EWU-IEEE-Spokane/squid-game-system/Control PCB/control/control.kicad_pcb

## KiCad design Control PCB/control/control.kicad_pcb (2022-09-03)

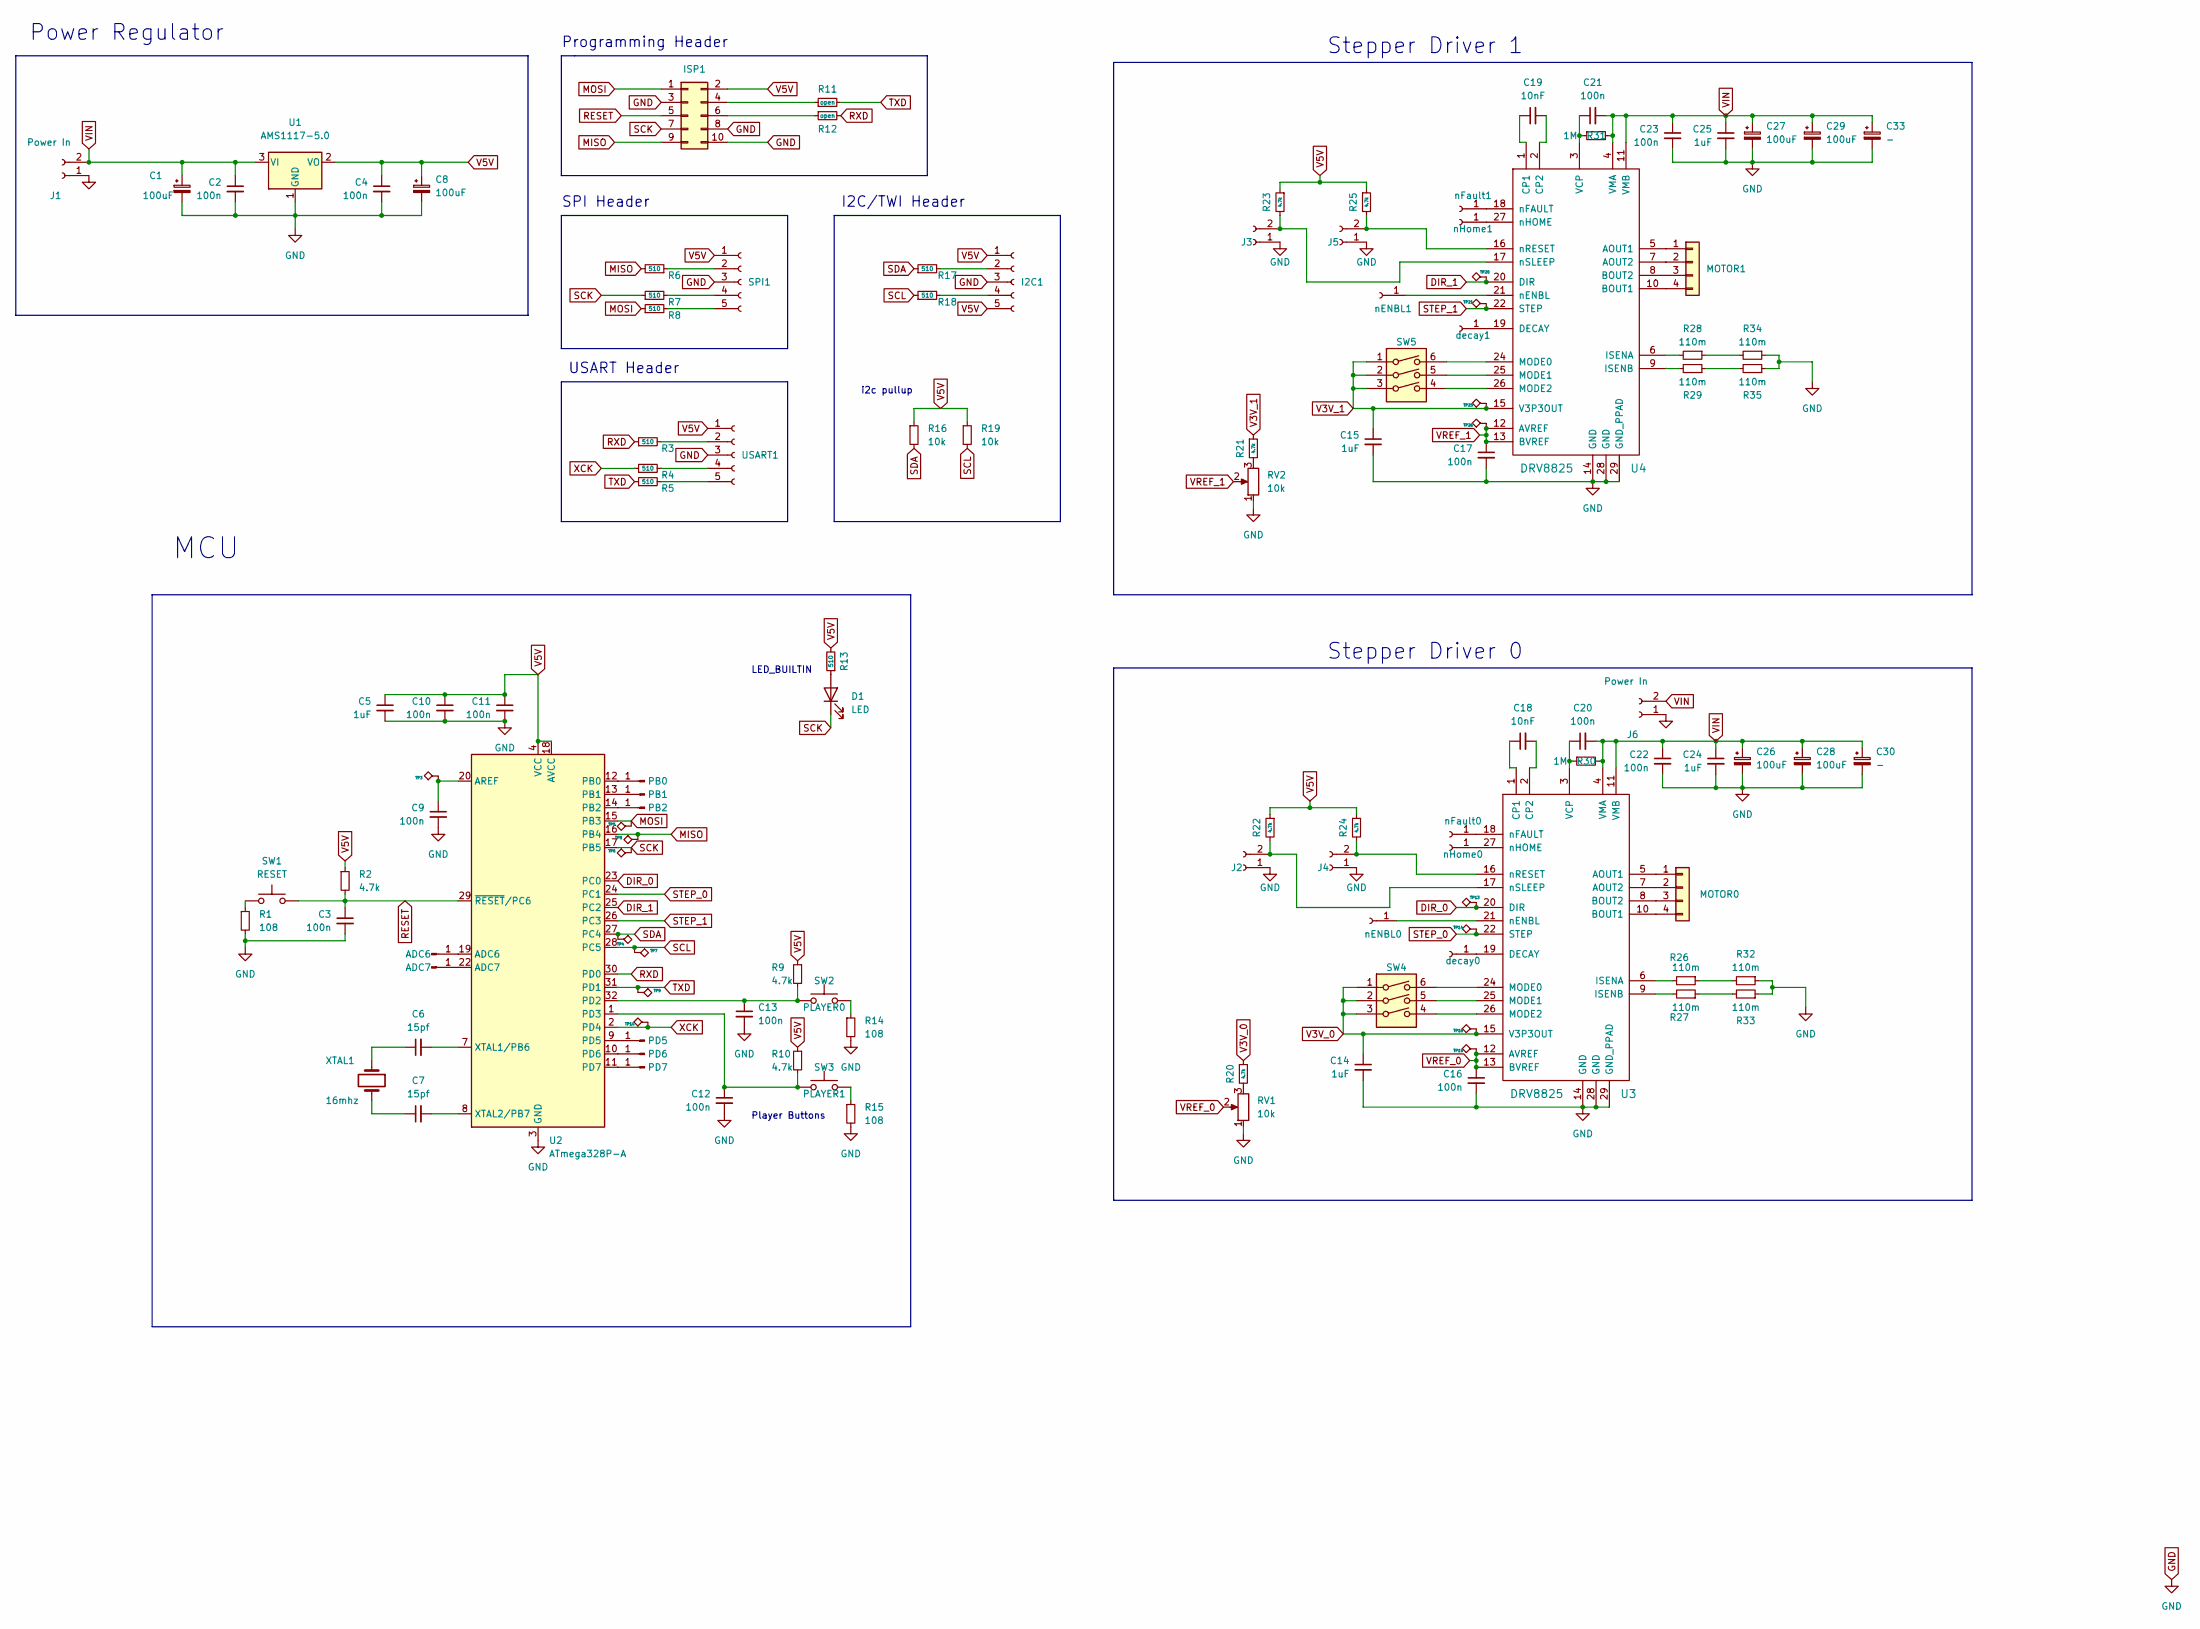
[picture p1: schematic control.kicad_sch]

Parts:
ADC6, ADC7: -; PinHeader_1x01_P2.54mm_Vertical
C1, C8, C26, C27, C28, C29: 100uF; CP_Radial_D10.0mm_P5.00mm
C2, C3, C4, C9, C10, C11, C12, C13, C16, C17, C20, C21, C22, C23: 100n; C_0805_2012Metric
C5, C14, C15, C24, C25: 1uF; C_0805_2012Metric
C6, C7: 15pf; C_0805_2012Metric
C18, C19: 10nF; R_0805_2012Metric_Pad1.20x1.40mm_HandSolder
C30, C33: -; CP_Radial_D10.0mm_P5.00mm
D1: LED; LED_D5.0mm
I2C1: -; PinHeader_1x05_P2.54mm_Vertical
ISP1: ISP; PinHeader_2x05_P2.54mm_Vertical
J1, J6: Power In; PinHeader_1x02_P2.54mm_Vertical
J2, J3, J4, J5: RST; PinHeader_1x02_P2.54mm_Vertical
MOTOR0, MOTOR1: -; PinHeader_1x04_P2.54mm_Vertical
PB0, PB1, PB2: -; PinHeader_1x01_P2.54mm_Vertical
PD5, PD6, PD7: -; PinHeader_1x01_P2.54mm_Vertical
R1, R14, R15: 108; R_0805_2012Metric_Pad1.20x1.40mm_HandSolder
R2, R9, R10, R20, R21, R22, R23, R24, R25: 4.7k; R_0805_2012Metric_Pad1.20x1.40mm_HandSolder
R3, R4, R5, R6, R7, R8, R13, R17, R18: 510; R_0805_2012Metric_Pad1.20x1.40mm_HandSolder
R11, R12: open; R_0805_2012Metric_Pad1.20x1.40mm_HandSolder
R16, R19: 10k; R_0805_2012Metric_Pad1.20x1.40mm_HandSolder
R26, R27, R28, R29, R32, R33, R34, R35: 110m; R_0612_1632Metric_Pad1.18x3.40mm_HandSolder
R30, R31: 1M; R_0805_2012Metric_Pad1.20x1.40mm_HandSolder
RV1, RV2: 10k; PinHeader_1x03_P2.54mm_Vertical
SPI1: -; PinHeader_1x05_P2.54mm_Vertical
SW1: RESET; SW_Push_1P1T_NO_CK_KSC6xxJ
SW2: PLAYER0; PinHeader_1x02_P2.54mm_Vertical
SW3: PLAYER1; PinHeader_1x02_P2.54mm_Vertical
SW4, SW5: MODE; SW_DIP_SPSTx03_Slide_6.7x9.18mm_W7.62mm_P2.54mm_LowProfile
TP3, TP4, TP5, TP6, TP7, TP8, TP9, TP10, TP13, TP14, TP18, TP19, TP20, TP21, TP25, TP26: -; testpoint
U1: AMS1117-5.0; SOT-223-3_TabPin2
U2: ATmega328P-A; TQFP-32_7x7mm_P0.8mm
U3, U4: DRV8825; HTSSOP-28_4.4x9.7mm_Pitch0.65mm_ThermalPad
USART1: -; PinHeader_1x05_P2.54mm_Vertical
XTAL1: 16mhz; Resonator-2Pin_W10.0mm_H5.0mm
decay0, decay1: -; PinHeader_1x01_P2.54mm_Vertical
nENBL0, nENBL1: -; PinHeader_1x01_P2.54mm_Vertical
nFault0, nFault1: -; PinHeader_1x01_P2.54mm_Vertical
nHome0, nHome1: -; PinHeader_1x01_P2.54mm_Vertical

Connections:
DIR_0: TP13.1, U2.23 (PC0), U3.20 (DIR)
DIR_1: TP20.1, U2.25 (PC2), U4.20 (DIR)
GND: C1.2, C2.2, C3.2, C4.2, C5.2, C8.2, C9.2, C10.2, C11.2, C12.2, C13.2, C14.2, C15.2, C16.2, C17.2, C22.2, C23.2, C24.2, C25.2, C26.2, C27.2, C28.2, C29.2, C30.2, C33.2, I2C1.3, ISP1.3, ISP1.8, ISP1.10, J1.1, J2.1, J3.1, J4.1, J5.1, J6.1, R1.2, R14.2, R15.2, R32.1, R33.1, R34.1, R35.1, RV1.1, RV2.1, SPI1.3, U1.1 (GND), U2.3 (GND), U2.5 (GND), U2.21 (GND), U3.14 (GND), U3.28 (GND), U3.29 (GND_PPAD), U4.14 (GND), U4.28 (GND), U4.29 (GND_PPAD), USART1.3
MISO: ISP1.9, R6.2, TP8.1, U2.16 (PB4)
MOSI: ISP1.1, R8.1, TP5.1, U2.15 (PB3)
unnamed: ADC6.1, U2.19 (ADC6)
unnamed: ADC7.1, U2.22 (ADC7)
unnamed: C6.1, XTAL1.1
unnamed: C6.2, U2.7 (XTAL1/PB6)
unnamed: C7.1, XTAL1.2
unnamed: C7.2, U2.8 (XTAL2/PB7)
unnamed: C9.1, TP3.1, U2.20 (AREF)
unnamed: C12.1, R10.2, SW3.1, U2.1 (PD3)
unnamed: C13.1, R9.2, SW2.1, U2.32 (PD2)
unnamed: C18.1, U3.1 (CP1)
unnamed: C18.2, U3.2 (CP2)
unnamed: C19.1, U4.1 (CP1)
unnamed: C19.2, U4.2 (CP2)
unnamed: C20.1, R30.1, U3.3 (VCP)
unnamed: C21.1, R31.1, U4.3 (VCP)
unnamed: D1.2 (A), R13.1
unnamed: I2C1.2, R17.2
unnamed: I2C1.4, R18.2
unnamed: ISP1.4, R11.1
unnamed: ISP1.6, R12.1
unnamed: J2.2, R22.2, U3.17 (nSLEEP)
unnamed: J3.2, R23.2, U4.17 (nSLEEP)
unnamed: J4.2, R24.2, U3.16 (nRESET)
unnamed: J5.2, R25.2, U4.16 (nRESET)
unnamed: MOTOR0.1, U3.5 (AOUT1)
unnamed: MOTOR0.2, U3.7 (AOUT2)
unnamed: MOTOR0.3, U3.8 (BOUT2)
unnamed: MOTOR0.4, U3.10 (BOUT1)
unnamed: MOTOR1.1, U4.5 (AOUT1)
unnamed: MOTOR1.2, U4.7 (AOUT2)
unnamed: MOTOR1.3, U4.8 (BOUT2)
unnamed: MOTOR1.4, U4.10 (BOUT1)
unnamed: PB0.1, U2.12 (PB0)
unnamed: PB1.1, U2.13 (PB1)
unnamed: PB2.1, U2.14 (PB2)
unnamed: PD5.1, U2.9 (PD5)
unnamed: PD6.1, U2.10 (PD6)
unnamed: PD7.1, U2.11 (PD7)
unnamed: R1.1, SW1.1
unnamed: R3.2, USART1.2
unnamed: R4.2, USART1.4
unnamed: R5.2, USART1.5
unnamed: R6.1, SPI1.2
unnamed: R7.2, SPI1.4
unnamed: R8.2, SPI1.5
unnamed: R14.1, SW2.2
unnamed: R15.1, SW3.2
unnamed: R20.2, RV1.3
unnamed: R21.2, RV2.3
unnamed: R26.1, R32.2
unnamed: R27.1, R33.2
unnamed: R28.1, R34.2
unnamed: R28.2, U4.6 (ISENA)
unnamed: R29.1, R35.2
unnamed: R29.2, U4.9 (ISENB)
unnamed: SW4.4, U3.26 (MODE2)
unnamed: SW4.5, U3.25 (MODE1)
unnamed: SW4.6, U3.24 (MODE0)
unnamed: SW5.4, U4.26 (MODE2)
unnamed: SW5.5, U4.25 (MODE1)
unnamed: SW5.6, U4.24 (MODE0)
unnamed: R26.2, U3.6 (ISENA)
unnamed: R27.2, U3.9 (ISENB)
unnamed: U3.18 (nFAULT), nFault0.1
unnamed: U3.19 (DECAY), decay0.1
unnamed: U3.21 (nENBL), nENBL0.1
unnamed: U3.27 (nHOME), nHome0.1
unnamed: U4.18 (nFAULT), nFault1.1
unnamed: U4.19 (DECAY), decay1.1
unnamed: U4.21 (nENBL), nENBL1.1
unnamed: U4.27 (nHOME), nHome1.1
RESET: C3.1, ISP1.5, R2.2, SW1.2, U2.29 (~RESET/PC6)
RXD: R3.1, R12.2, U2.30 (PD0)
SCK: D1.1 (K), ISP1.7, R7.1, TP6.1, U2.17 (PB5)
SCL: R18.1, R19.2, TP7.1, U2.28 (PC5)
SDA: R16.2, R17.1, TP4.1, U2.27 (PC4)
STEP_0: TP14.1, U2.24 (PC1), U3.22 (STEP)
STEP_1: TP21.1, U2.26 (PC3), U4.22 (STEP)
TXD: R5.1, R11.2, TP9.1, U2.31 (PD1)
V3V_0: C14.1, R20.1, SW4.1, SW4.2, SW4.3, TP18.1, U3.15 (V3P3OUT)
V3V_1: C15.1, R21.1, SW5.1, SW5.2, SW5.3, TP25.1, U4.15 (V3P3OUT)
V5V: C4.1, C5.1, C8.1, C10.1, C11.1, I2C1.1, I2C1.5, ISP1.2, R2.1, R9.1, R10.1, R13.2, R16.1, R19.1, R22.1, R23.1, R24.1, R25.1, SPI1.1, U1.2 (VO), U2.4 (VCC), U2.6 (VCC), U2.18 (AVCC), USART1.1
VIN: C1.1, C2.1, C20.2, C21.2, C22.1, C23.1, C24.1, C25.1, C26.1, C27.1, C28.1, C29.1, C30.1, C33.1, J1.2, J6.2, R30.2, R31.2, U1.3 (VI), U3.4 (VMA), U3.11 (VMB), U4.4 (VMA), U4.11 (VMB)
VREF_0: C16.1, RV1.2, TP19.1, U3.12 (AVREF), U3.13 (BVREF)
VREF_1: C17.1, RV2.2, TP26.1, U4.12 (AVREF), U4.13 (BVREF)
XCK: R4.1, TP10.1, U2.2 (PD4)

Notes on the sheet:
Player Buttons
Stepper Driver 0
USART Header
SPI Header
i2c pullup
I2C/TWI Header
MCU
Stepper Driver 1
LED_BUILTIN
Power Regulator
Programming Header

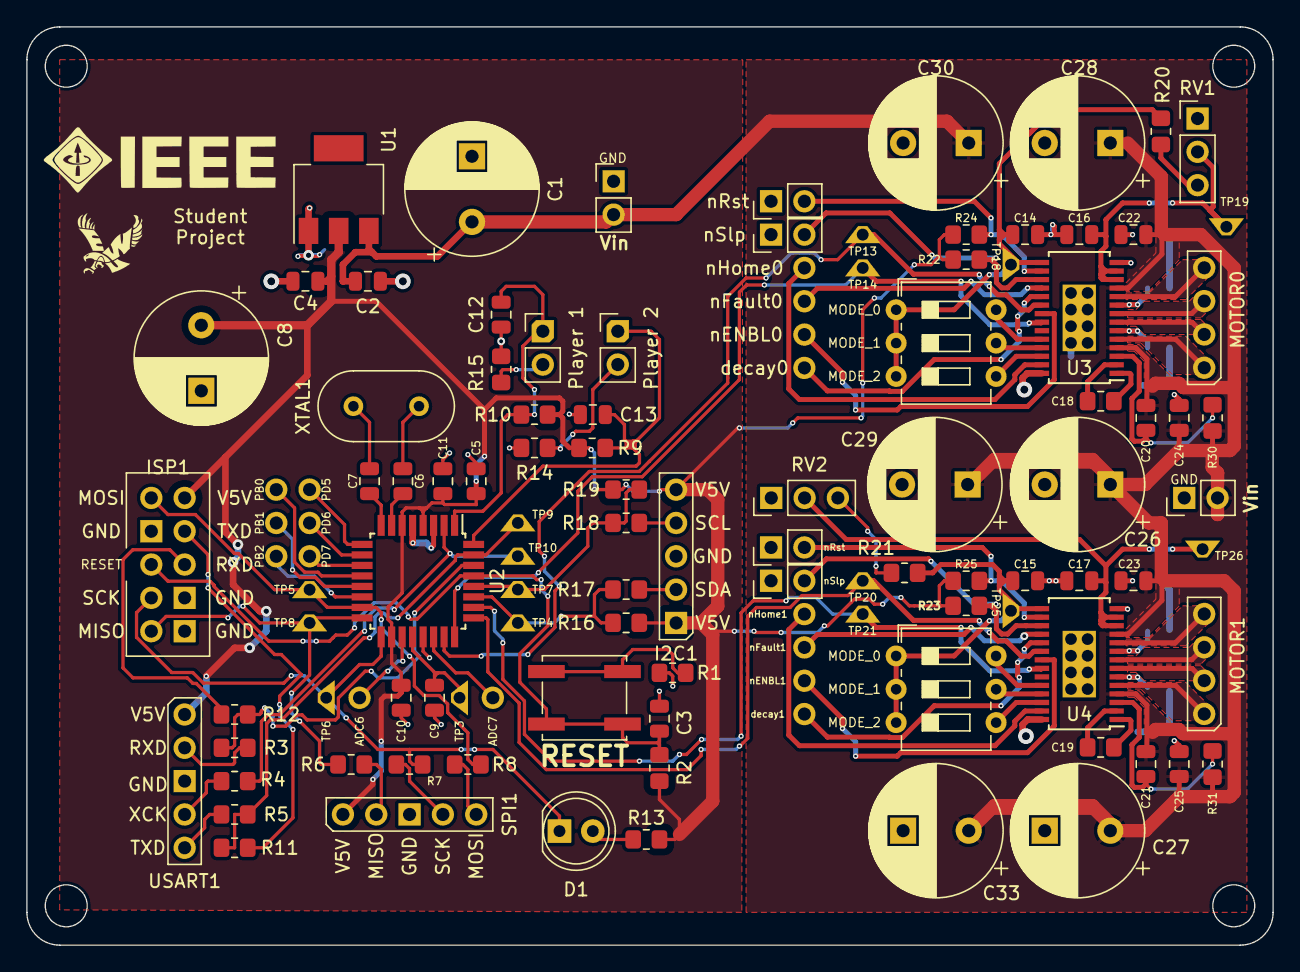
[picture p2: board control.kicad_pcb from above]

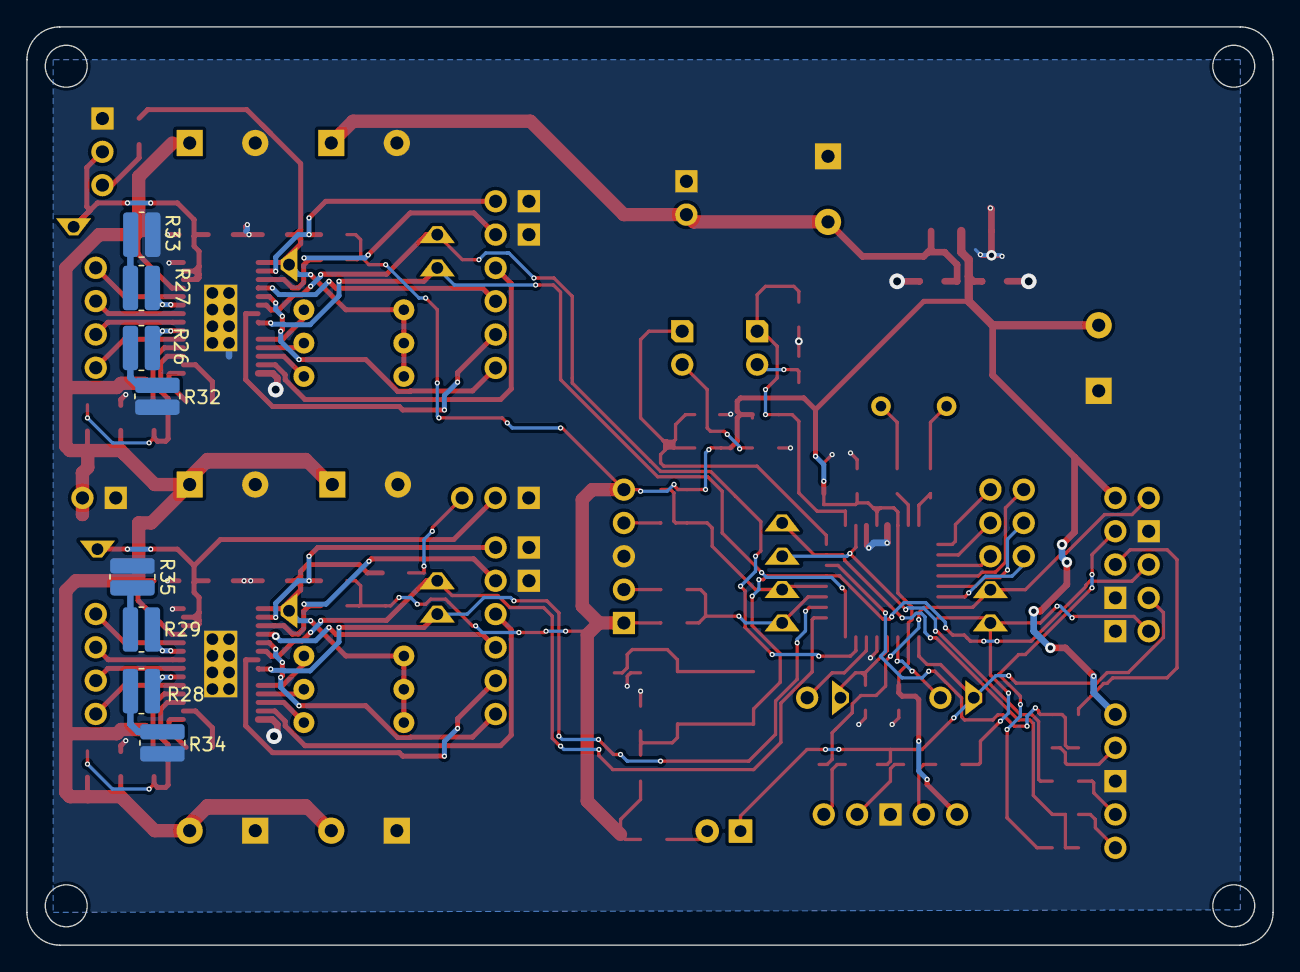
[picture p3: board control.kicad_pcb from below]

Board: 2 copper layers, 95.0 x 70.0 mm, 123 parts (8 on the bottom side), 91 nets.
