EWU-IEEE-Spokane/squid-game-system/(threads)

Thread 1 (2022-09-02):

Draw pulleys for 3d printing

jkmunson, 2022-09-02:
We need 2 pulley designs.
The belt being used is a 3/8" V-belt. This should be a standard size.

1. Drive pulley, for stepper motor. Stepper motor has a 5mm shaft, which should be secured against with a set screw or flat in the pulley design.
2. Driven Pulley, to support the opposite end of the belt. Should fit ball bearings - to be measured during weekend meeting.

Once the designs are complete, commit them to /squid-game-system/pulleys

jkmunson, 2022-09-09:
The diameter of the pulley TBD. probably 2 inches or so?
