EWU-IEEE-Spokane/squid-game-system/(commit log)

2022-09-03 Initial PCB design
    [control.kicad_pcb, control.kicad_sch]
2022-09-05 PCB Fabrication Outputs
    [control.kicad_sch]
2022-09-07 Wrote stepper motor control interface.
2022-09-07 Added stepper::getCurrentPosition() method. Small tweeks.
    Small formatting changes.
    Added volatile to speedDivisor, as it's shared.
    Changed a few comments to be clearer.
2022-09-08 Numerous improvements. Changed stepper::tick() frequency from 2khz to 4khz
    1. Changed _Timer to Timer_
    (Names beginning with _ are reserved by the language)
    2. Changed MAX_SUBSCRIBERS_TIMER2 to const uint8_t maxSubscribers, moved it into the Timer_ class.
    (It's existence as a macro implied, incorrectly, that it could be changed there. Changes to the max subscriber count would also require changes to the timer hardware setup in Timer_::begin() )
    3. Made handling of Timer_::subscriber type safe
    4. Added stepper_error(char *errMsg) for unrecoverable errors. Prints errMsg in a loop to the serial output. Changed Timer_::subscribe to use this function.
    5. Added range checking to the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
2022-09-08 Made all stepper member functions safe to access anywhere
2022-09-08 stepper::stepHigh doesn't need to be volatile.
2022-09-10 Modified stepper::tick() to respect DRV8825 timing requirements.
    There must be a minimum wait time between changing "DIR" and issuing a pulse at "STEP" of 650ns. Before this change, there was a delay of only 680ns.
    I placed the other useful work in the same code block inbetween the two writes, and added an assembly line to force the compiler to respect ordering. The delay is now ~1600ns which leaves some breathing room.
    This change made stepper::tick() ~4 clock cycles longer in the worse case. (Redundant reads caused by the barriers)
2022-09-12 Fix support for multiple stepper motors.
    missing tickCount++; in Timer_::tick()
    Update Timer2_::begin() accordingly, to fix tick rate.
2022-10-08 Place things in folder, as needed by arduino ide
2023-09-26 Faster operation of the timer - 4 times as fast
    Allows finer-grained control of stepper motor speed.
2023-09-26 Faster stepper operation - 8x
    Allows finer grained control of stepper motor speed.
2023-09-26 Change timer maximum subscribers number to 2 for faster stepper ticks
